MKozuch/EyeControl/README.md

# EyeControl
An embeded plaftorm for controlling stuff with your eyes and, in the future, maybe the other way around too.
