MKozuch/EyeControl/Hardware/EyeControl/EyeControl.brd

## EAGLE design Hardware/EyeControl/EyeControl.brd (2016-04-14)

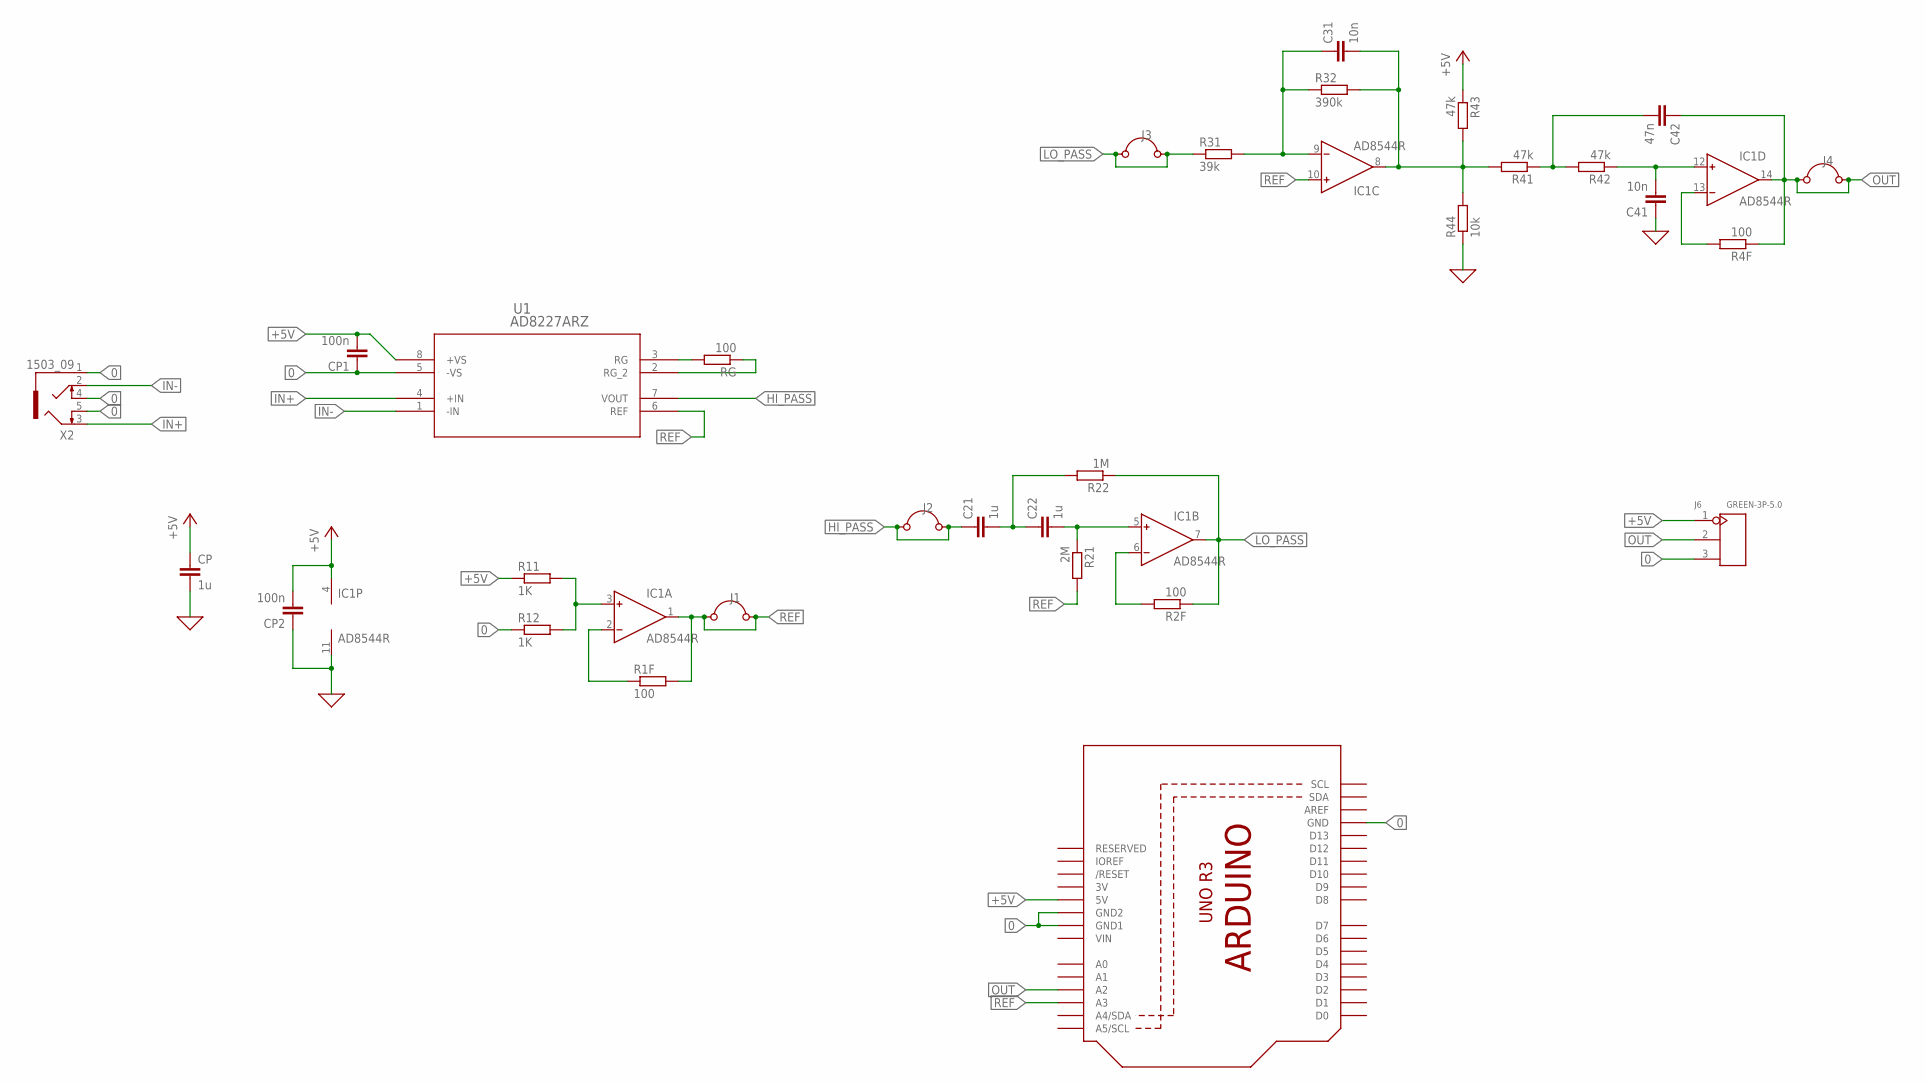
[picture p11: schematic EyeControl.sch]

Parts:
C21, C22: 1u; C0805
C31, C41: 10n; C0805
C42: 47n; C0805
CP: 1u; C0805
CP1, CP2: 100n; C0805
IC1: AD8544R; SO14
J1, J2, J3, J4: JUMPER; 05
J6: GREEN-3P-5.0; H3-5.0-15.5X8.0MM
R1F, R2F, R4F: 100; R1206
R11, R12: 1K; R1206
R21: 2M; R1206
R22: 1M; R1206
R31: 39k; R1206
R32: 390k; R1206
R41, R42, R43: 47k; R1206
R44: 10k; R1206
RG: 100; R1206
U1: AD8227ARZ; R_8
U$1: ARDUINOR3-DIMENSION; ARDUINOR3
X2: 1503_09

Connections:
0: C41.1, CP.2, CP1.1, CP2.1, IC1.11 (V-), J6.3, R12.1, R44.1, U1.5 (-VS), U$1.GND, U$1.GND1, U$1.GND2, X2.1, X2.4, X2.5
3V: U$1.3V
+5V: CP.1, CP1.2, CP2.2, IC1.4 (V+), J6.1, R11.1, R43.1, U1.8 (+VS), U$1.5V
HI_PASS: C21.1, J2.1 (+), J2.2 (-), U1.7 (VOUT)
IN+: U1.4 (+IN), X2.3
IN-: U1.1 (-IN), X2.2
LO_PASS: IC1.7 (OUT), J3.1 (+), J3.2 (-), R2F.1, R22.1, R31.1
unnamed: C31.1, IC1.9 (IN-), R31.2, R32.1
unnamed: C41.2, IC1.12 (IN+), R42.1
unnamed: IC1.2 (IN-), R1F.1
unnamed: IC1.3 (IN+), R11.2, R12.2
unnamed: C42.2, R41.1, R42.2
unnamed: C21.2, C22.1, R22.2
unnamed: RG.1, U1.2 (RG_2)
unnamed: RG.2, U1.3 (RG)
unnamed: C22.2, IC1.5 (IN+), R21.1
unnamed: C31.2, IC1.8 (OUT), R32.2, R41.2, R43.2, R44.2
unnamed: IC1.6 (IN-), R2F.2
unnamed: IC1.13 (IN-), R4F.2
OUT: C42.1, IC1.14 (OUT), J4.1 (+), J4.2 (-), J6.2, R4F.1, U$1.A2
REF: IC1.1 (OUT), IC1.10 (IN+), J1.1 (+), J1.2 (-), R1F.2, R21.2, U1.6 (REF), U$1.A3
VIN: U$1.VIN

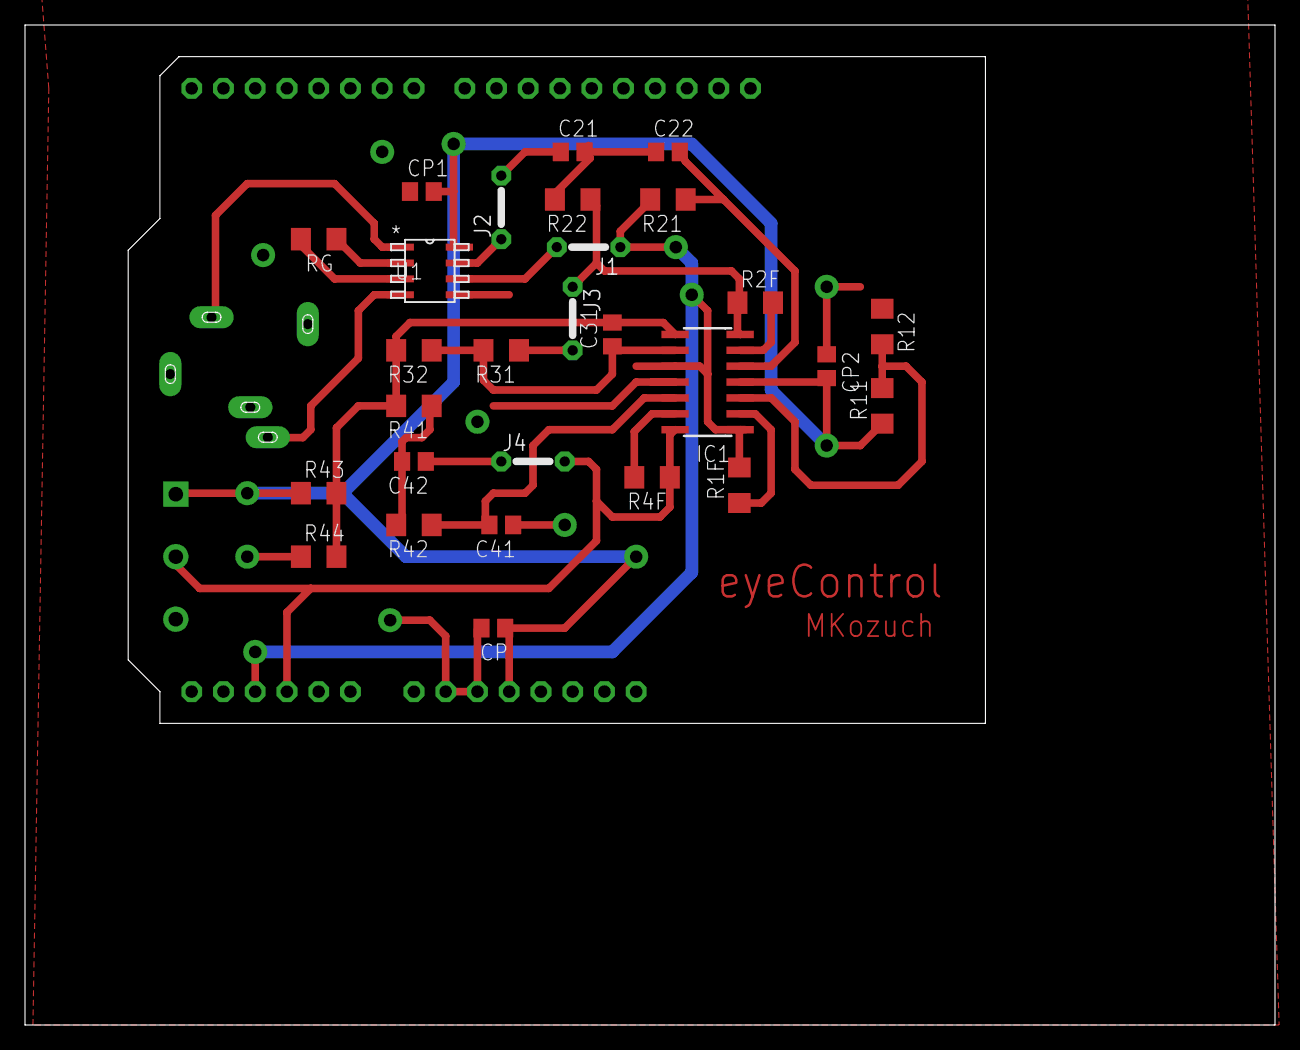
[picture p12: board EyeControl.brd from above]

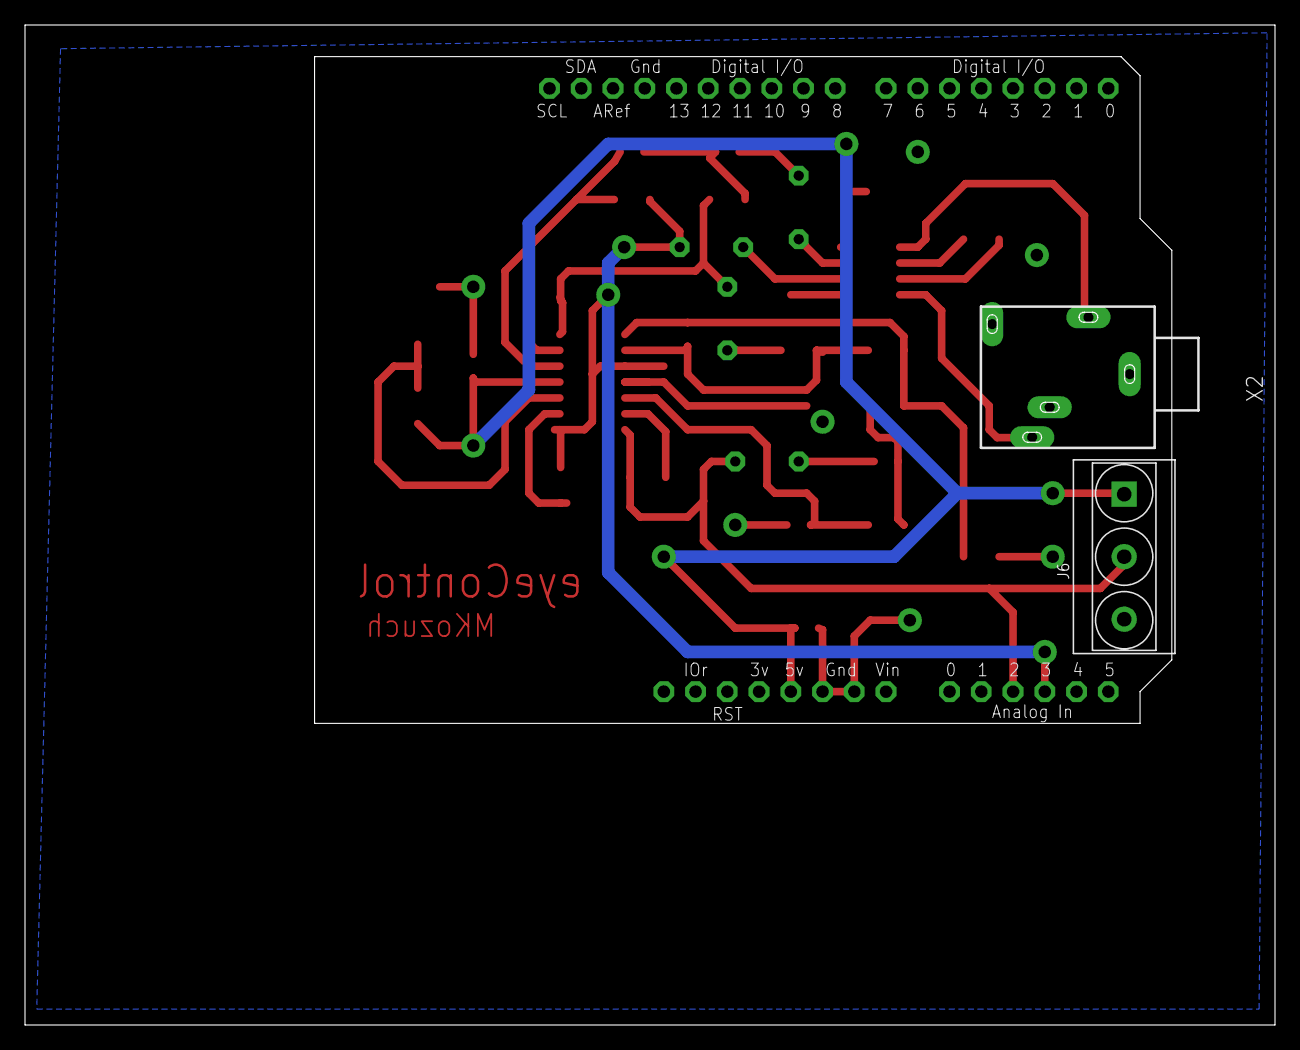
[picture p13: board EyeControl.brd from below]

Board: 2 copper layers, 100.0 x 80.0 mm, 31 parts (3 on the bottom side), 20 nets.
