MKozuch/EyeControl/Hardware/LedDisp/untitled.brd

## EAGLE design Hardware/LedDisp/untitled.brd (2016-04-14)

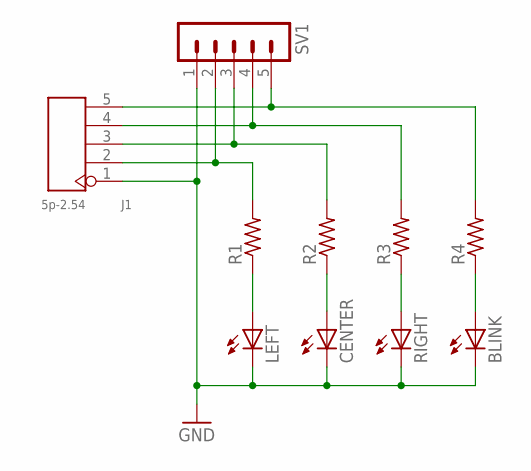
[picture p14: schematic untitled.sch]

Parts:
BLINK: LED5MM
CENTER: LED5MM
J1: 5p-2.54; H5-2.54-11.06X6.3MM
LEFT: LED5MM
R1, R2, R3, R4: FLIPFLOP-RES; 0805-THM
RIGHT: LED5MM
SV1: MA05-1

Connections:
GND: BLINK.K (C), CENTER.K (C), J1.1, LEFT.K (C), RIGHT.K (C), SV1.1
unnamed: J1.4, R3.2, SV1.4
unnamed: LEFT.A, R1.1
unnamed: BLINK.A, R4.1
unnamed: R3.1, RIGHT.A
unnamed: CENTER.A, R2.1
unnamed: J1.2, R1.2, SV1.2
unnamed: J1.5, R4.2, SV1.5
unnamed: J1.3, R2.2, SV1.3

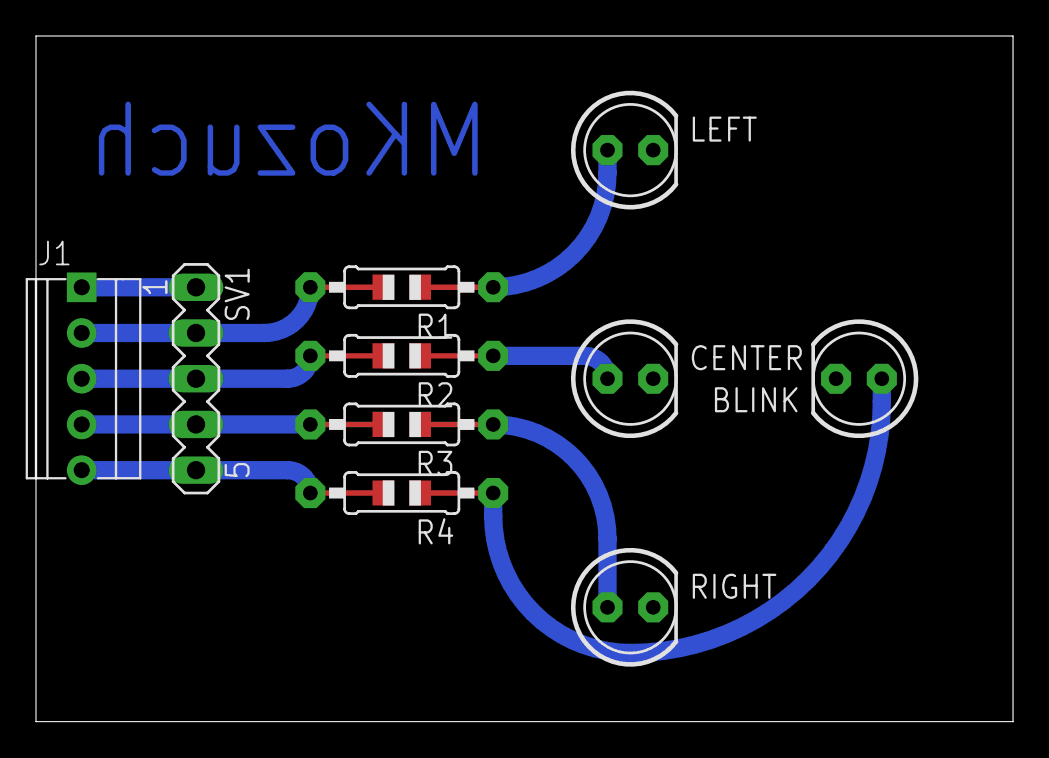
[picture p15: board untitled.brd from above]

Board: 2 copper layers, 54.3 x 38.1 mm, 10 parts (0 on the bottom side), 9 nets.
